sungbeom0324/ETROC_to_FPGA/image/3d_render/ETROC_to_FPGA_Back.png

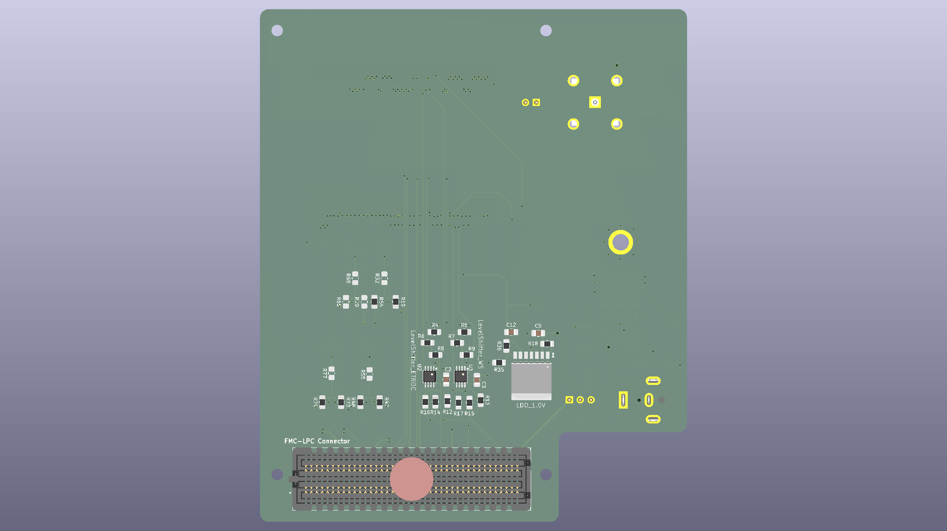
image/3d_render/ETROC_to_FPGA_Back.png
