sungbeom0324/ETROC_to_FPGA/README.md

## ETROC_to_FPGA Board

This board is designed to connect probe card for hybrid (LGAD+ETROC) sensor to FPGA (KC705) board. \
Reversible usage for debugging is also supported, by properly populating components (To be explained).
