sungbeom0324/ETROC_to_FPGA/image/real_picture/Board_Configs_Front.pdf

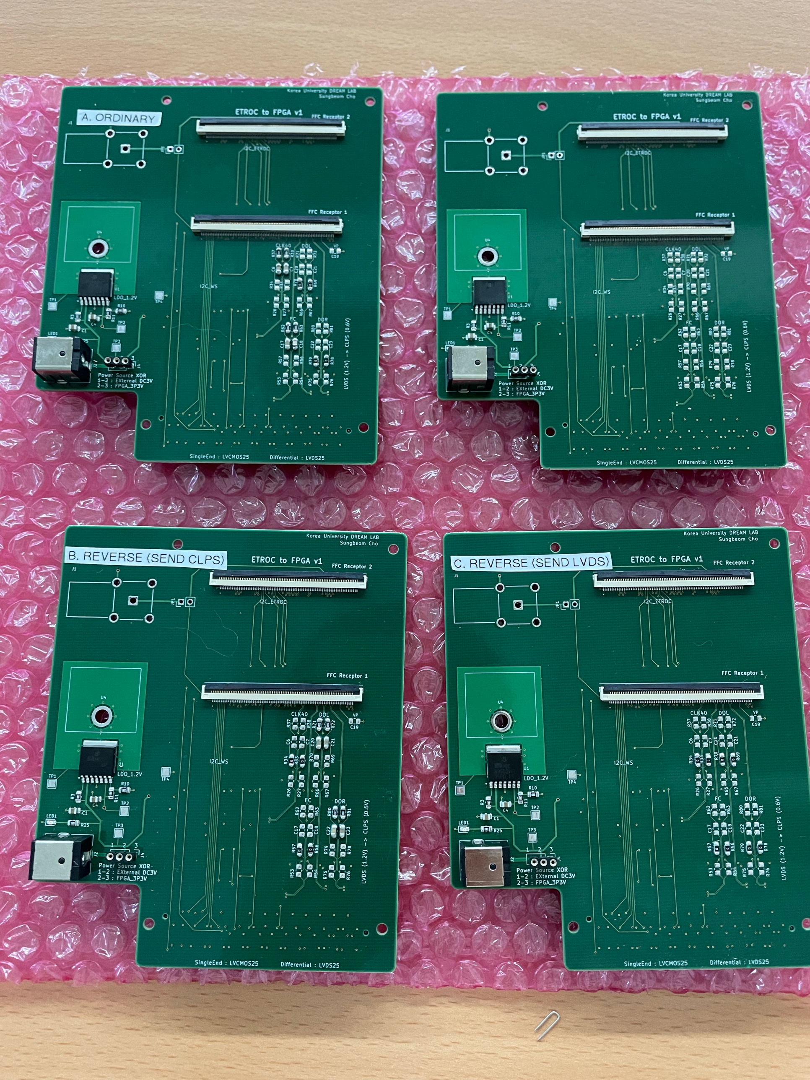
[picture p3: page 1]
