sungbeom0324/ETROC_to_FPGA/image/real_picture/Board_Configs_Rear.pdf

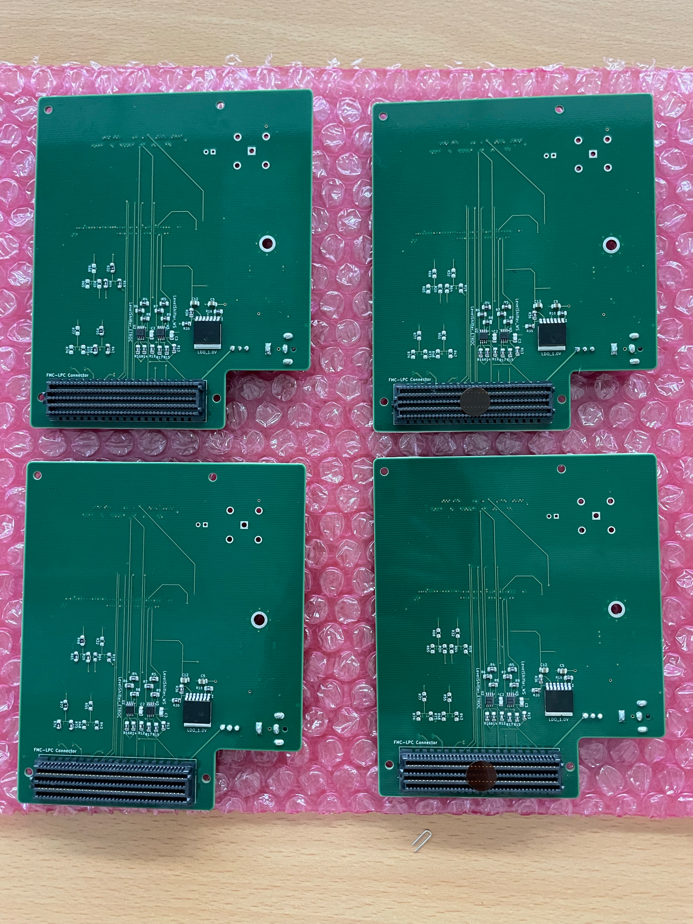
[picture p4: page 1]
