sungbeom0324/ETROC_to_FPGA/image/real_picture/Connect_to_KC705-FMC.pdf

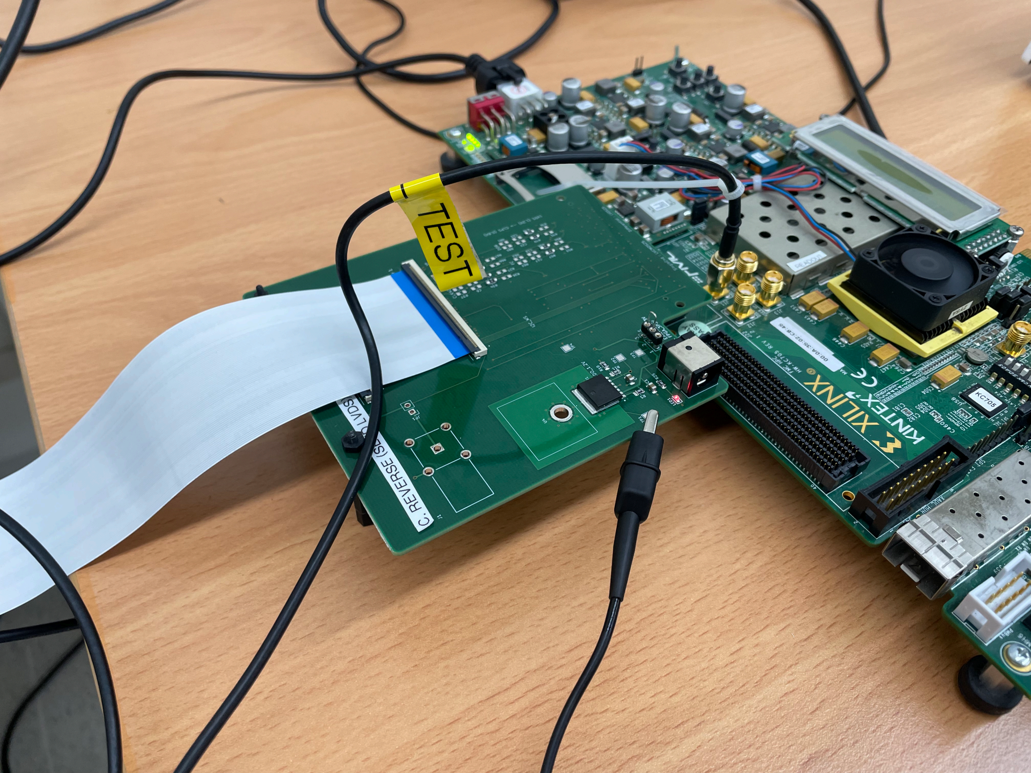
[picture p5: page 1]
