sungbeom0324/ETROC_to_FPGA/image/real_picture/Ordinary_Board_Front.pdf

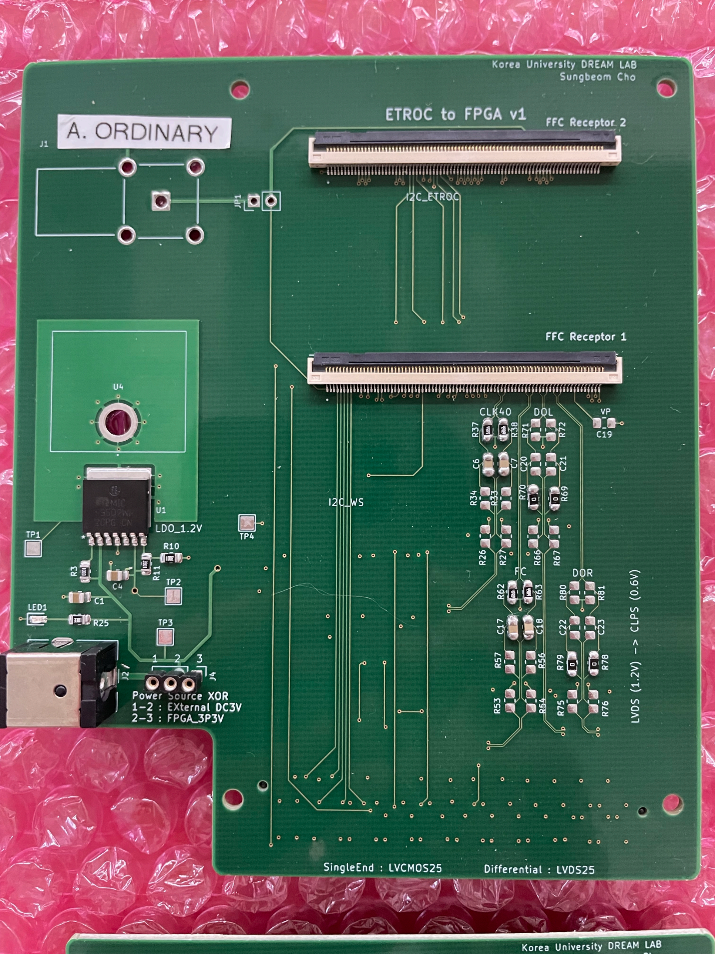
[picture p6: page 1]
