sungbeom0324/ETROC_to_FPGA/image/real_picture/Ordinary_Board_Rear.pdf

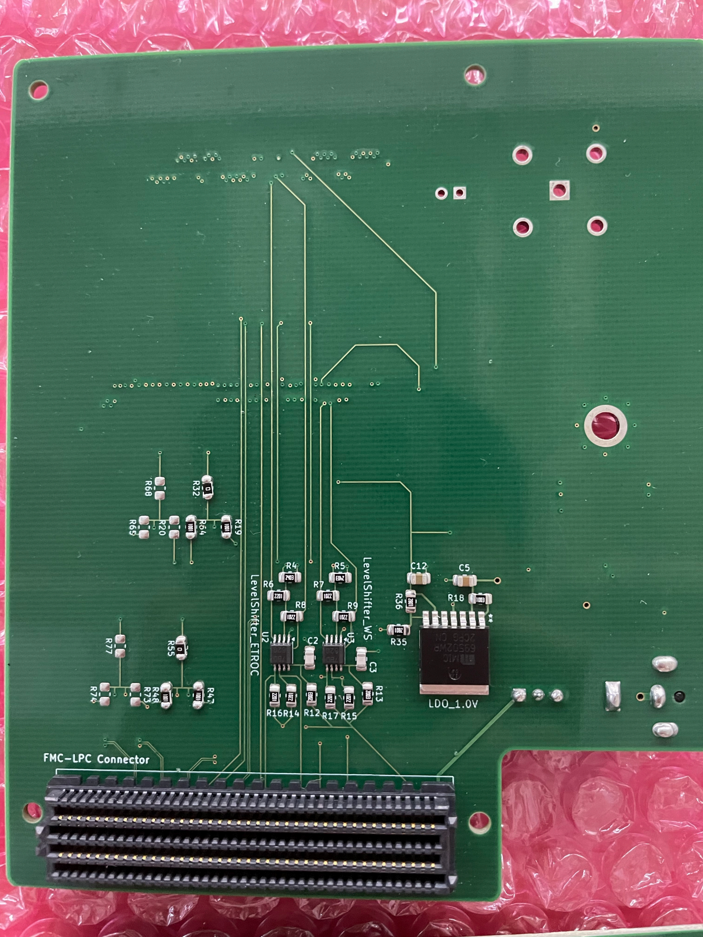
[picture p7: page 1]
