sungbeom0324/ETROC_to_FPGA/Fabrication/BOM/ETROC_to_FPGA_BOM.xlsx

Reference | Qty | Value | DNP | Component | Type | Packed | Footprint | Datasheet | Manufacturer_Part_Number | Mouser Part Number | Description | #
C1,C4,C5,C12 | 4 | 10uF |  | CC0805MKX7R7BB106 | Tape | o | Capacitor_SMD:C_0805_2012Metric_Pad1.18x1.45mm_HandSolder | https://www.mouser.kr/ProductDetail/YAGEO/CC0805MKX7R7BB106?qs=WS5Jv%252B%252Bx1qV0JXGhy8Ef5g%3D%3D |  |  | Unpolarized capacitor | 1
C2,C3 | 2 | 100pF |  | CC0805JRNPO9BN101 | Tape | o | Capacitor_SMD:C_0805_2012Metric_Pad1.18x1.45mm_HandSolder | https://www.mouser.kr/ProductDetail/YAGEO/CC0805JRNPO9BN101?qs=AgBp2OyFlx%252BIBvbseB%252BJ9Q%3D%3D |  |  | Unpolarized capacitor | 2
C6,C7,C17,C18,C20,C21,C22,C23 | 8 | 100n | DNP | CC0805KRX7R9BB104 | Tape |  | Capacitor_SMD:C_0805_2012Metric_Pad1.18x1.45mm_HandSolder | https://www.mouser.kr/ProductDetail/YAGEO/CC0805KRX7R9BB104?qs=vTakOoo5QyLx0lXWgVtRhQ%3D%3D |  |  | Unpolarized capacitor | 3
C19 | 1 | 10n | DNP | N/A | Tape |  | Capacitor_SMD:C_0805_2012Metric_Pad1.18x1.45mm_HandSolder | https://www.mouser.kr/ProductDetail/YAGEO/CC0805MKX7R7BB106?qs=WS5Jv%252B%252Bx1qV0JXGhy8Ef5g%3D%3D |  |  | Unpolarized capacitor | 4
J1 | 1 | Conn_Coaxial | DNP | N/A | N/A |  | ETROC_to_FPGA:BNCLRPC140 |  |  |  | coaxial connector (BNC, SMA, SMB, SMC, Cinch/RCA, LEMO, ...) | 5
J2 | 1 | Barrel_Jack | DNP | PJ-063AH | Bulk | o | Connector_BarrelJack:BarrelJack_CUI_PJ-063AH_Horizontal | https://www.mouser.kr/ProductDetail/Same-Sky/PJ-063AH?qs=WyjlAZoYn51bQfA53nMcVA%3D%3D |  |  | DC Barrel Jack | 6
J3 | 1 | Conn_01x03_Socket | DNP | N/A | N/A |  | Connector:FanPinHeader_1x03_P2.54mm_Vertical |  |  |  | Generic connector, single row, 01x03, script generated | 7
J4 | 1 | Conn_01x03 | DNP | N/A | N/A |  | Connector_PinHeader_2.54mm:PinHeader_1x03_P2.54mm_Vertical |  |  |  | Generic connector, single row, 01x03, script generated (kicad-library-utils/schlib/autogen/connector/) | 8
J5,J6 | 2 | TF06L-80S-0.5SH_800_ |  | TF06L-80S-0.5SH (800) | Tape | o | ETROC_to_FPGA:TF06L80S05SH800 | https://www.mouser.kr/ProductDetail/Hirose-Connector/TF06L-80S-0.5SH800?qs=W0yvOO0ixfGr8OqBVw%252Bw9w%3D%3D | TF06L-80S-0.5SH(800) | 798-TF06L-80S05SH800 | FFC & FPC Connectors | 9
J7 | 1 | ASP-134604-01 |  | ASP-134604-01 | Tape | o | ETROC_to_FPGA:ASP13460401 | https://componentsearchengine.com/Datasheets/2/ASP-134604-01.pdf | ASP-134604-01 | 200-ASP-134604-01 | SAMTEC - ASP-134604-01 - Board-To-Board Connector, Vita 57 XMC, 1.27 mm, 160 Contacts, Header, ASP Series, Surface Mount | 10
JP1 | 1 | Jumper_2_Open | DNP | N/A | N/A |  | Connector_PinHeader_2.54mm:PinHeader_1x02_P2.54mm_Vertical |  |  |  | Jumper, 2-pole, open | 11
LED1 | 1 | LTST-C190KRKT |  | LTST-C190KRKT | Tape | o | LEDC1608X80N | https://componentsearchengine.com/Datasheets/1/LTST-C190KRKT.pdf | LTST-C190KRKT | 859-LTST-C190KRKT | LED,SMD,0603,Red,54mcd,130deg Lite-On LTST-C190KRKT Red LED, 631 nm, 1608 (0603), Rectangle Lens SMD Package | 12
R3,R18 | 2 | 100k |  | RC0805FR-07100KL | Tape | o | Resistor_SMD:R_0805_2012Metric_Pad1.20x1.40mm_HandSolder | https://www.mouser.kr/ProductDetail/YAGEO/RC0805FR-07100KL?qs=8Y8p%252BasKcI7rEWn6FcVdAA%3D%3D |  |  | Resistor | 13
R4,R5 | 2 | 240k |  | RC0805FR-07240KL | Tape | o | Resistor_SMD:R_0805_2012Metric_Pad1.20x1.40mm_HandSolder | https://www.mouser.kr/ProductDetail/YAGEO/RC0805FR-07240KL?qs=fRxXYNj8ftEwbQYL8uxuAg%3D%3D |  |  | Resistor | 14
R6, R7, R8, R9, R14, R15, R16, R17 | 8 | 2.2k |  | RC0805FR-072K2L | Tape | o | Resistor_SMD:R_0805_2012Metric_Pad1.20x1.40mm_HandSolder | https://www.mouser.kr/ProductDetail/YAGEO/RC0805FR-072K2L?qs=CSLd874fYV2eT6iKTza3nw%3D%3D |  |  | Resistor | 15
R26,R27,R53,R54,R66,R67,R75,R76 | 8 | 2.2k | DNP | RC0805FR-072K2L | Tape |  | Resistor_SMD:R_0805_2012Metric_Pad1.20x1.40mm_HandSolder | https://www.mouser.kr/ProductDetail/YAGEO/RC0805FR-072K2L?qs=CSLd874fYV2eT6iKTza3nw%3D%3D |  |  | Resistor | 15
R10 | 1 | 2k |  | RC0805FR-072KL | Tape | o | Resistor_SMD:R_0805_2012Metric_Pad1.20x1.40mm_HandSolder | https://www.mouser.kr/ProductDetail/YAGEO/RC0805FR-072KL?qs=QrWOOBGzeCYk%2Fx0gjMNmqg%3D%3D |  |  | Resistor | 16
R11,R35,R36 | 3 | 2.8k |  | RC0805FR-072K8L | Tape | o | Resistor_SMD:R_0805_2012Metric_Pad1.20x1.40mm_HandSolder | https://www.mouser.kr/ProductDetail/YAGEO/RC0805FR-072K8L?qs=fRxXYNj8ftFpv%2FHTECUVlw%3D%3D |  |  | Resistor | 17
R12,R13 | 2 | 200k |  | RC0805FR-07200KL | Tape | o | Resistor_SMD:R_0805_2012Metric_Pad1.20x1.40mm_HandSolder | https://www.mouser.kr/ProductDetail/YAGEO/RC0805FR-07200KL?qs=8Y8p%252BasKcI4ufYuYh%252BmyZQ%3D%3D |  |  | Resistor | 18
R19,R20,R47,R48,R64,R65,R73,R74 | 8 | 1k | DNP | RC0805FR-071KL | Tape |  | Resistor_SMD:R_0805_2012Metric_Pad1.20x1.40mm_HandSolder | https://www.mouser.kr/ProductDetail/YAGEO/RC0805FR-071KL?qs=1ogmaHw32WJjeGY0DHXakQ%3D%3D |  |  | Resistor | 19
R25 | 1 | 3.3k |  | RC0805FR-073K3L | Tape | o | Resistor_SMD:R_0805_2012Metric_Pad1.20x1.40mm_HandSolder | https://www.mouser.kr/ProductDetail/YAGEO/RC0805FR-073K3L?qs=QrWOOBGzeCZ3pxZtTjPddw%3D%3D |  |  | Resistor | 20
R32,R33,R34,R55,R56,R57,R68,R69,R70,R77,R78,R79 | 12 | 0R | DNP | RC0805JR-070RL | Tape |  | Resistor_SMD:R_0805_2012Metric_Pad1.20x1.40mm_HandSolder | http://industrial.panasonic.com/www-cgi/jvcr13pz.cgi?E+PZ+3+AOA0001+ERJ2GE0R00X+7+WW | ERJ-2GE0R00X | 667-ERJ-2GE0R00X | General Purpose Chip Resistor | 21
R37,R38,R62,R63,R71,R72,R80,R81 | 8 | 50R | DNP | AC0805FR-0749R9L | Tape |  | Resistor_SMD:R_0805_2012Metric_Pad1.20x1.40mm_HandSolder | https://www.mouser.kr/ProductDetail/YAGEO/RC0805FR-0750RL?qs=Jslch3jnSjmZJw3GuNn5kw%3D%3D |  |  | Resistor | 22
U1,U5 | 2 | MIC69502WR |  | MIC69502WR | Tape | o | S-PAK-7_MCH | https://ww1.microchip.com/downloads/aemDocuments/documents/APID/ProductDocuments/DataSheets/MIC69502-5A-Low-VIN-Low-VOUT-%CE%BCCap-LDO-Regulator-DS20006836.pdf |  |  | LDO 3.3 (5)V -> 1.2V, 1.0V | 27
U2,U3 | 2 | PCA9306DCTR |  | PCA9306DCTR | Tape | o | Package_SO:SSOP-8_2.95x2.8mm_P0.65mm | http://www.ti.com/lit/ds/symlink/pca9306.pdf |  |  | Dual bidirectional I2C Bus and SMBus voltage level translator | 28
U4 | 1 | 504102B00000G | DNP | 504102B00000G | Bulk | o | 504102B00000G | https://www.mouser.kr/ProductDetail/Aavid/504102B00000G?qs=MJut%252BdqOEgj5oeHehsjqHA%3D%3D | 504102B00000G | 532-504102B00 | Heatsink, TO-220, 15.6C/W, 19.8 x 17.8 x 21.6mm, Through Hole | 29
