sungbeom0324/ETROC_to_FPGA/3D/LTST-C190KRKT.stp

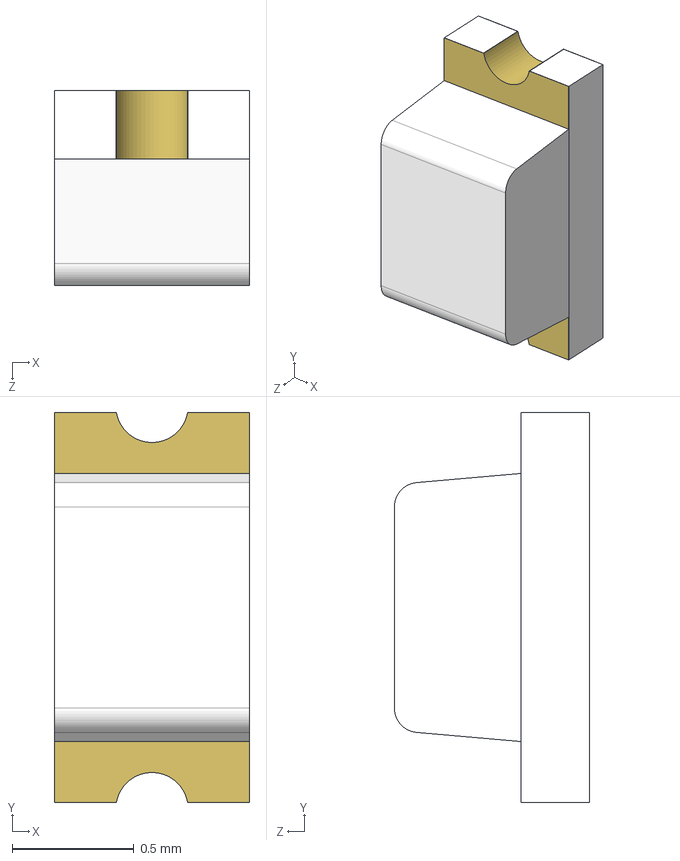
[picture p8: CAD file, 2026-05-17]
3D/LTST-C190KRKT.stp
0.8 x 1.60 x 0.801 mm
