sungbeom0324/ETROC_to_FPGA/3D/S-PAK-7_MCH.step

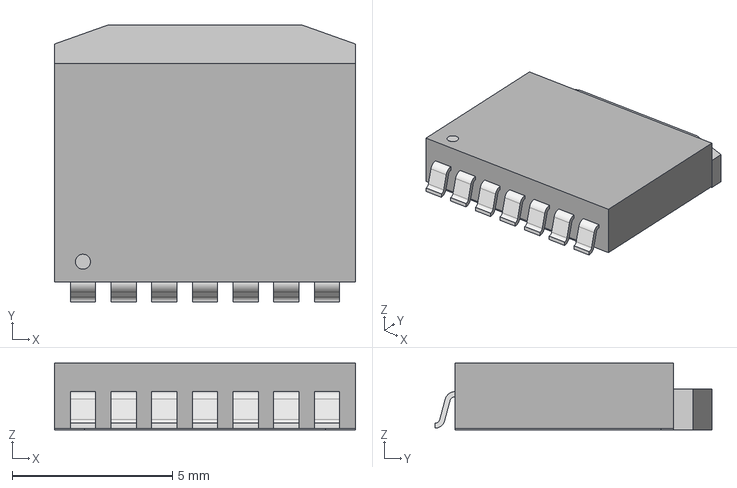
[picture p9: CAD file, 2026-05-17]
3D/S-PAK-7_MCH.step
9.40 x 8.66 x 2.09 mm
