sungbeom0324/ETROC_to_FPGA/3D/TF06L-80S-0.5SH_800_.stp

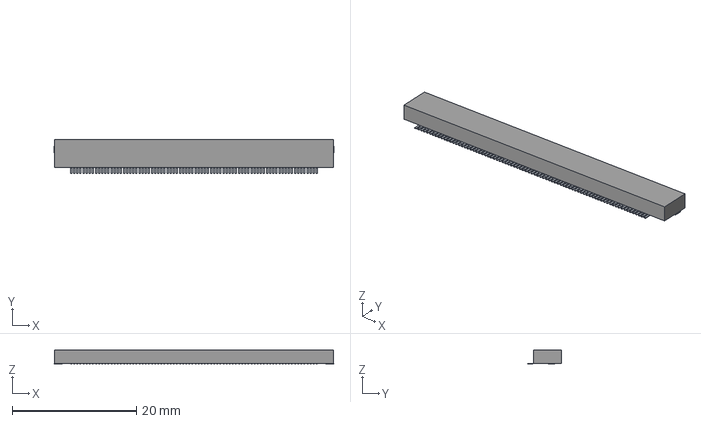
[picture p10: CAD file, 2026-05-17]
3D/TF06L-80S-0.5SH_800_.stp
45.0 x 5.42 x 2.30 mm
Pins
