sungbeom0324/ETROC_to_FPGA/3D/ERJ-2GE0R00X.stp

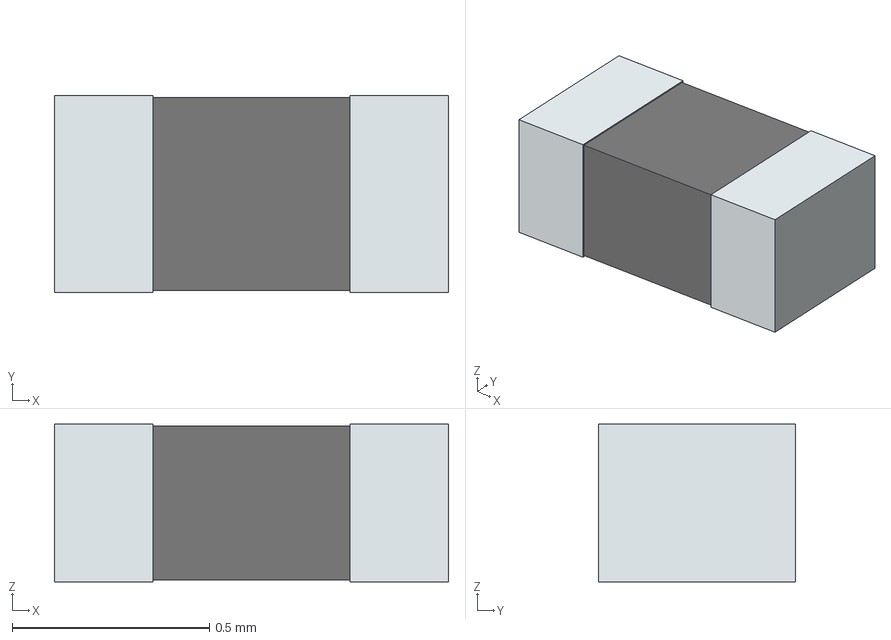
[picture p11: CAD file, 2026-05-17]
3D/ERJ-2GE0R00X.stp
1.00 x 0.5 x 0.4 mm
term1
term2
