sungbeom0324/ETROC_to_FPGA/3D/ASP-134488-01.stp

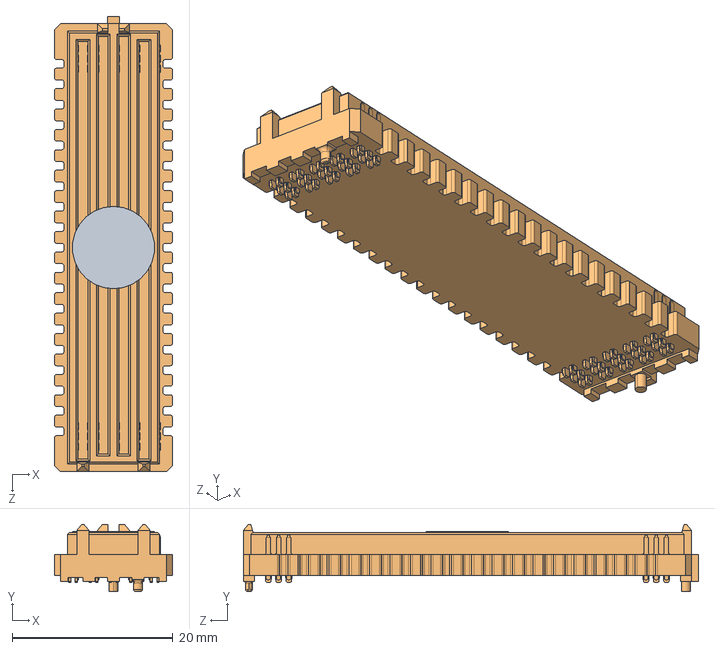
[picture p12: CAD file, 2026-05-17]
3D/ASP-134488-01.stp
14.7 x 8.38 x 56.7 mm
