sungbeom0324/ETROC_to_FPGA/3D/BNC-LR-PC-1_40_.stp

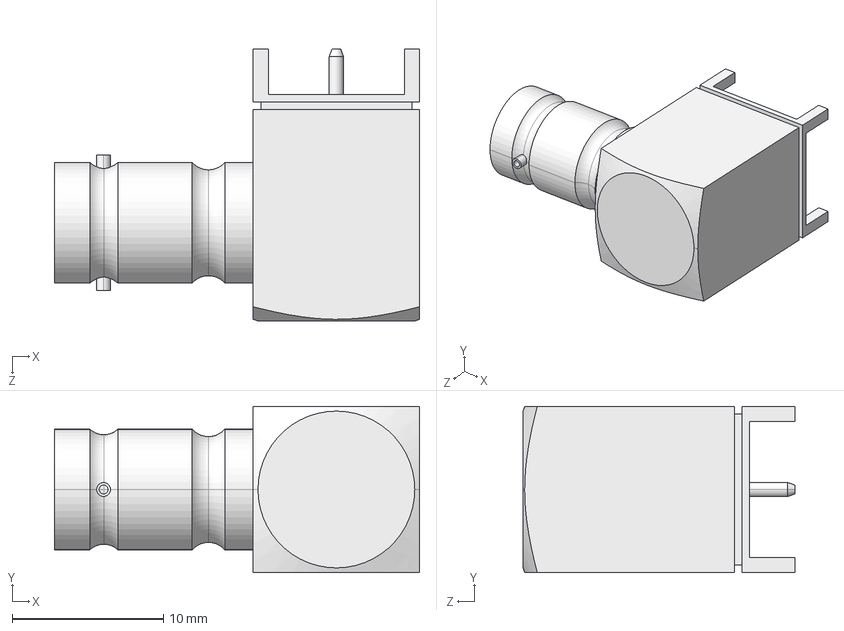
[picture p13: CAD file, 2026-05-17]
3D/BNC-LR-PC-1_40_.stp
24.1 x 11.0 x 18.0 mm
