sungbeom0324/ETROC_to_FPGA/3D/ASP-134486-01.stp

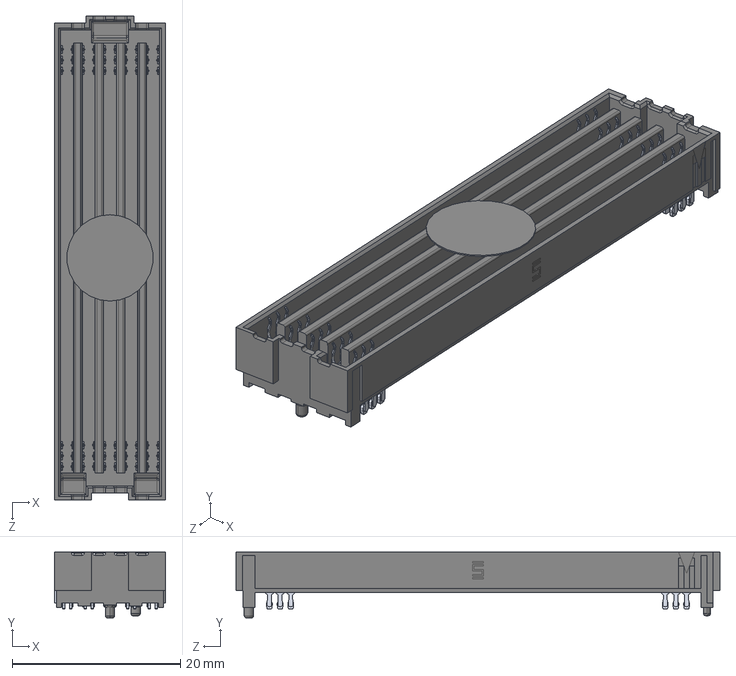
[picture p14: CAD file, 2026-05-17]
3D/ASP-134486-01.stp
13.2 x 7.82 x 57.5 mm
