sungbeom0324/ETROC_to_FPGA/3D/HSE19-361616P.stp

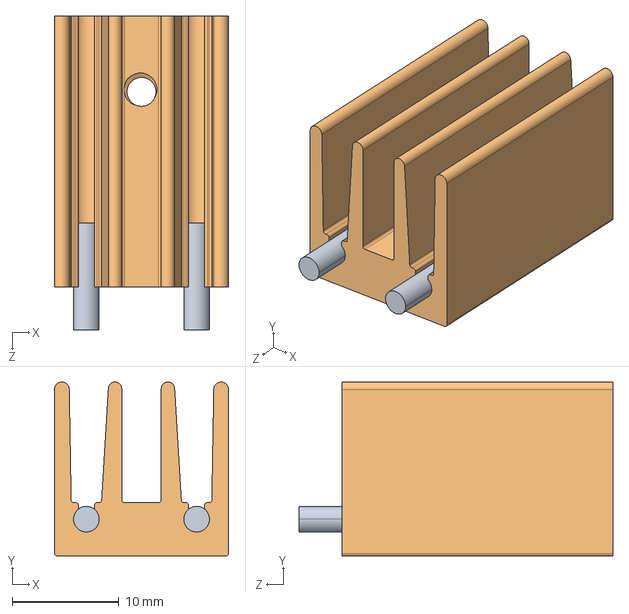
[picture p15: CAD file, 2026-05-17]
3D/HSE19-361616P.stp
16.3 x 16.3 x 29.4 mm
