sungbeom0324/ETROC_to_FPGA/3D/504102B00000G.stp

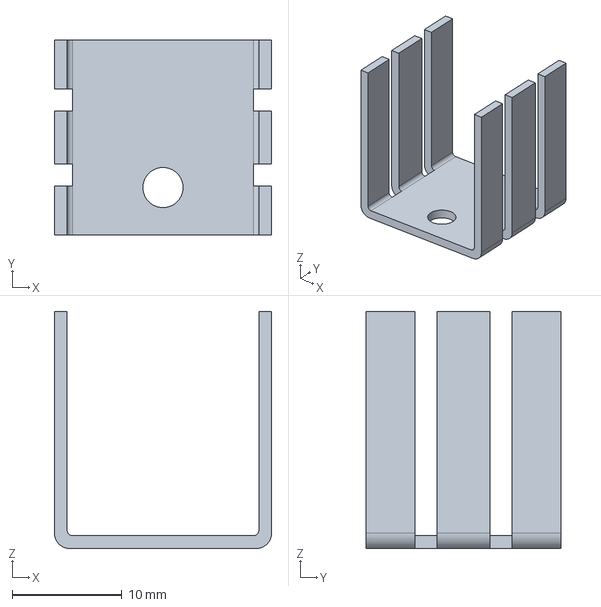
[picture p16: CAD file, 2026-05-17]
3D/504102B00000G.stp
19.8 x 17.8 x 21.6 mm
