sungbeom0324/ETROC_to_FPGA/3D/694106301002.stp

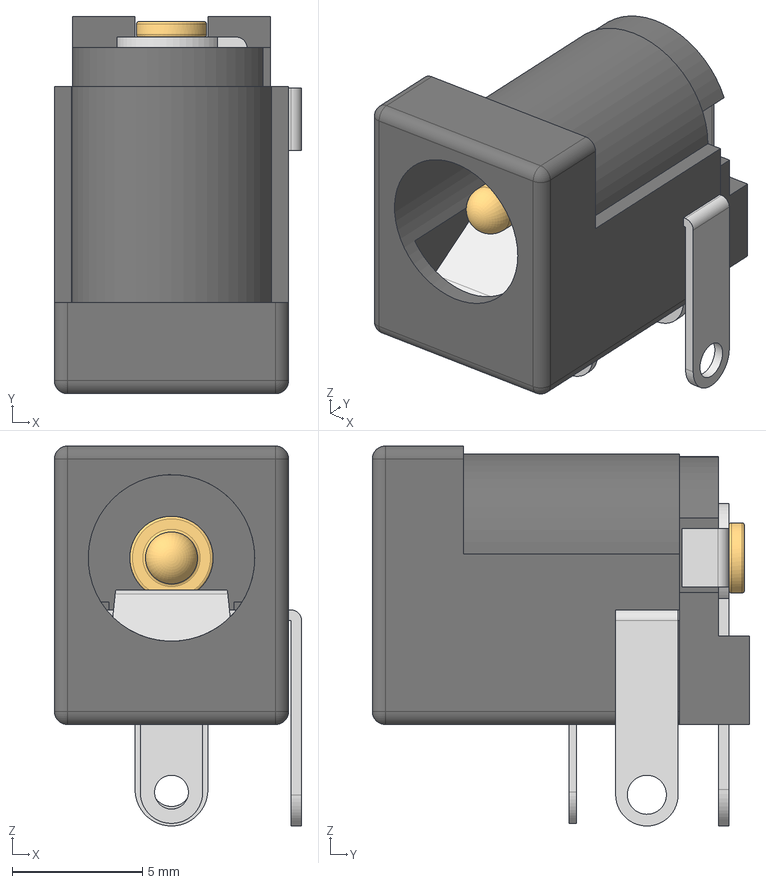
[picture p17: CAD file, 2026-05-17]
3D/694106301002.stp
9.50 x 14.5 x 14.6 mm
6941xx301002
694106301002_PinContact
6941xx301002_Back
6941xx301002_PinContact2
6941xx301002_PinLame
6941xx301002_PinBis
