sungbeom0324/ETROC_to_FPGA/3D/5226993-3.stp

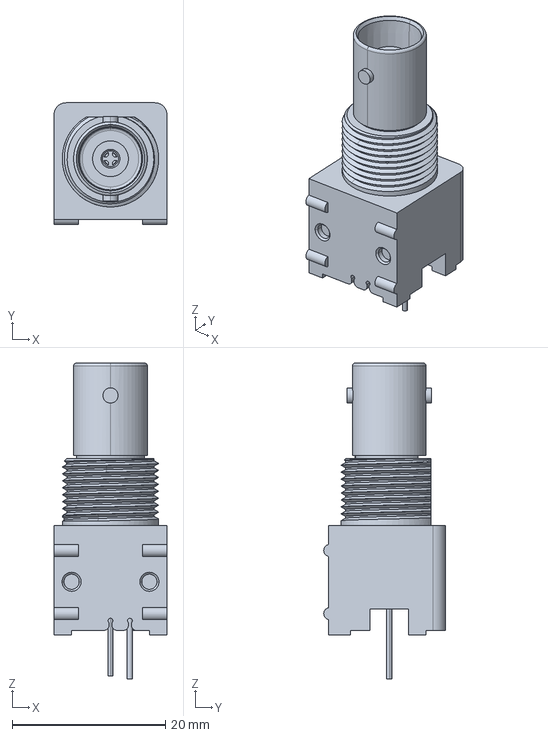
[picture p18: CAD file, 2026-05-17]
3D/5226993-3.stp
14.8 x 15.9 x 41.3 mm
