sungbeom0324/ETROC_to_FPGA/image/real_picture/Reverse_Board_Test_Setup.pdf

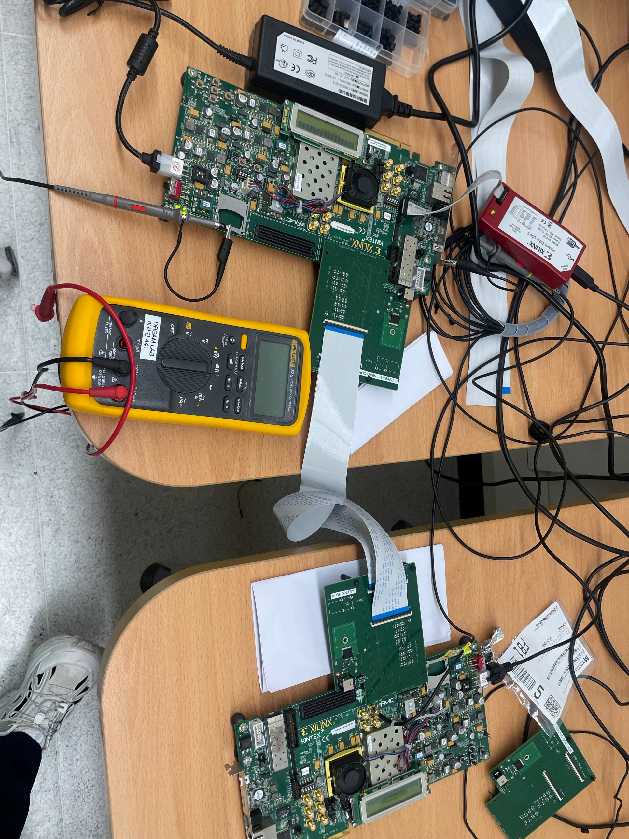
[picture p19: page 1]
