sungbeom0324/ETROC_to_FPGA/image/schematic/ETROC_to_FPGA_schematic.pdf

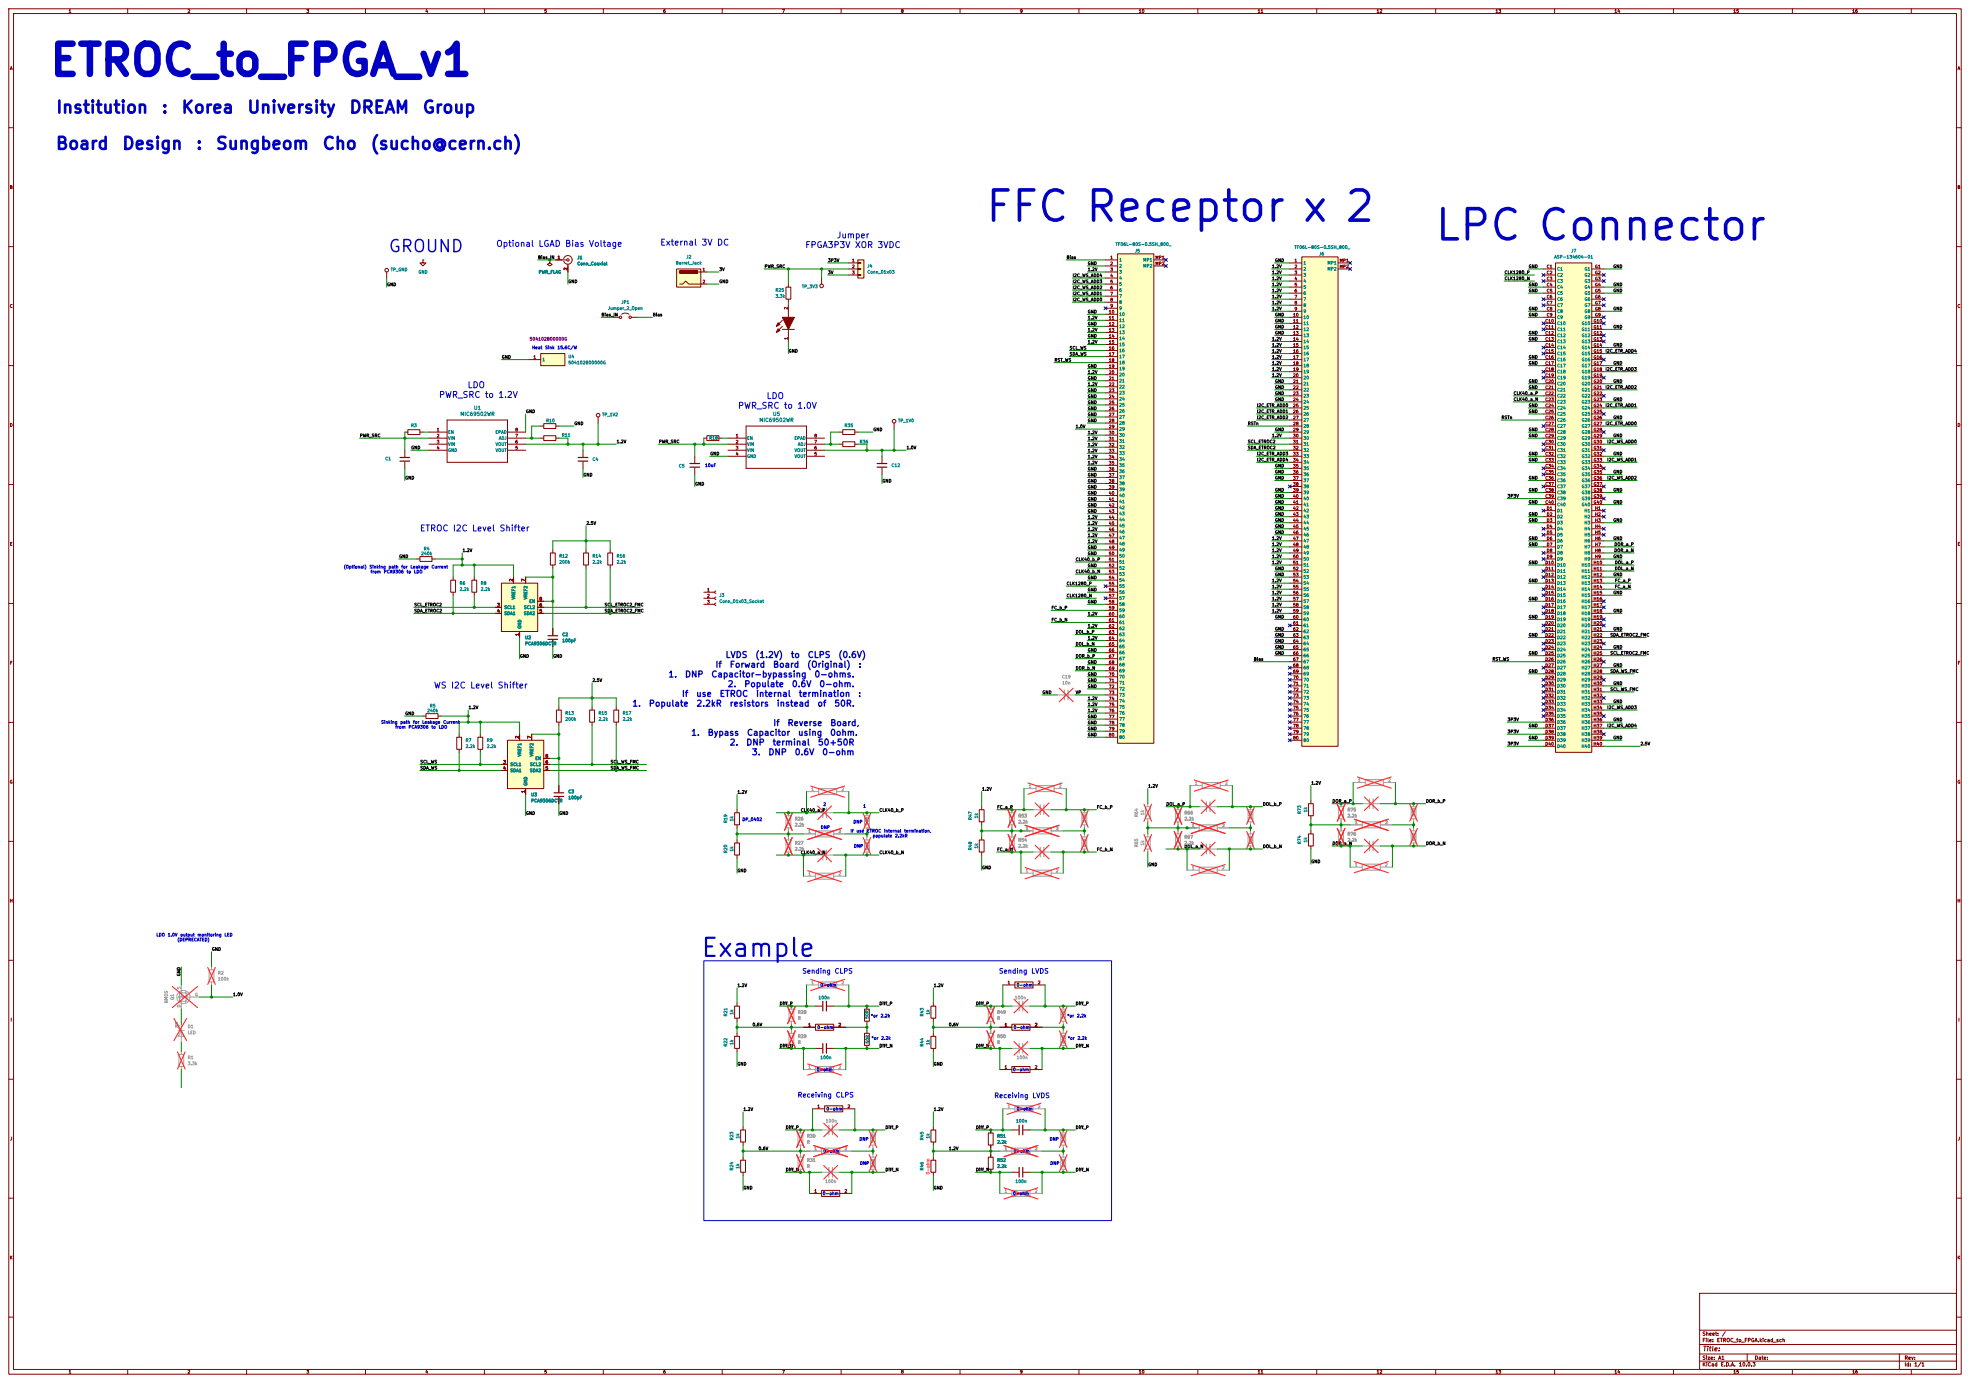
[picture p20: page 1]

Institution : Korea University DREAM Group
Board Design : Sungbeom Cho (sucho@cern.ch)

Optional LGAD Bias Voltage

(Optional) Sinking path for Leakage Current

2 LVDS (1.2V) to CLPS (0.6V)
If Forward Board (Original) :
2. Populate 0.6V 0-ohm.

1. DNP Capacitor-bypassing 0-ohms.
If use ETROC internal termination :

0-ohm WS I2C Level Shifter

1. Populate 2.2kR resistors instead of 50R.

Sinking path for Leakage Current

If use ETROC internal termination,

LDO 1.0V output monitoring LED

Size: A1 | Rev:
KiCad E.D.A. 10.0.3 | Id: 1/1
