sungbeom0324/ETROC_to_FPGA/ETROC_to_FPGA.kicad_pcb

## KiCad design ETROC_to_FPGA.kicad_pcb (2026-08-05)

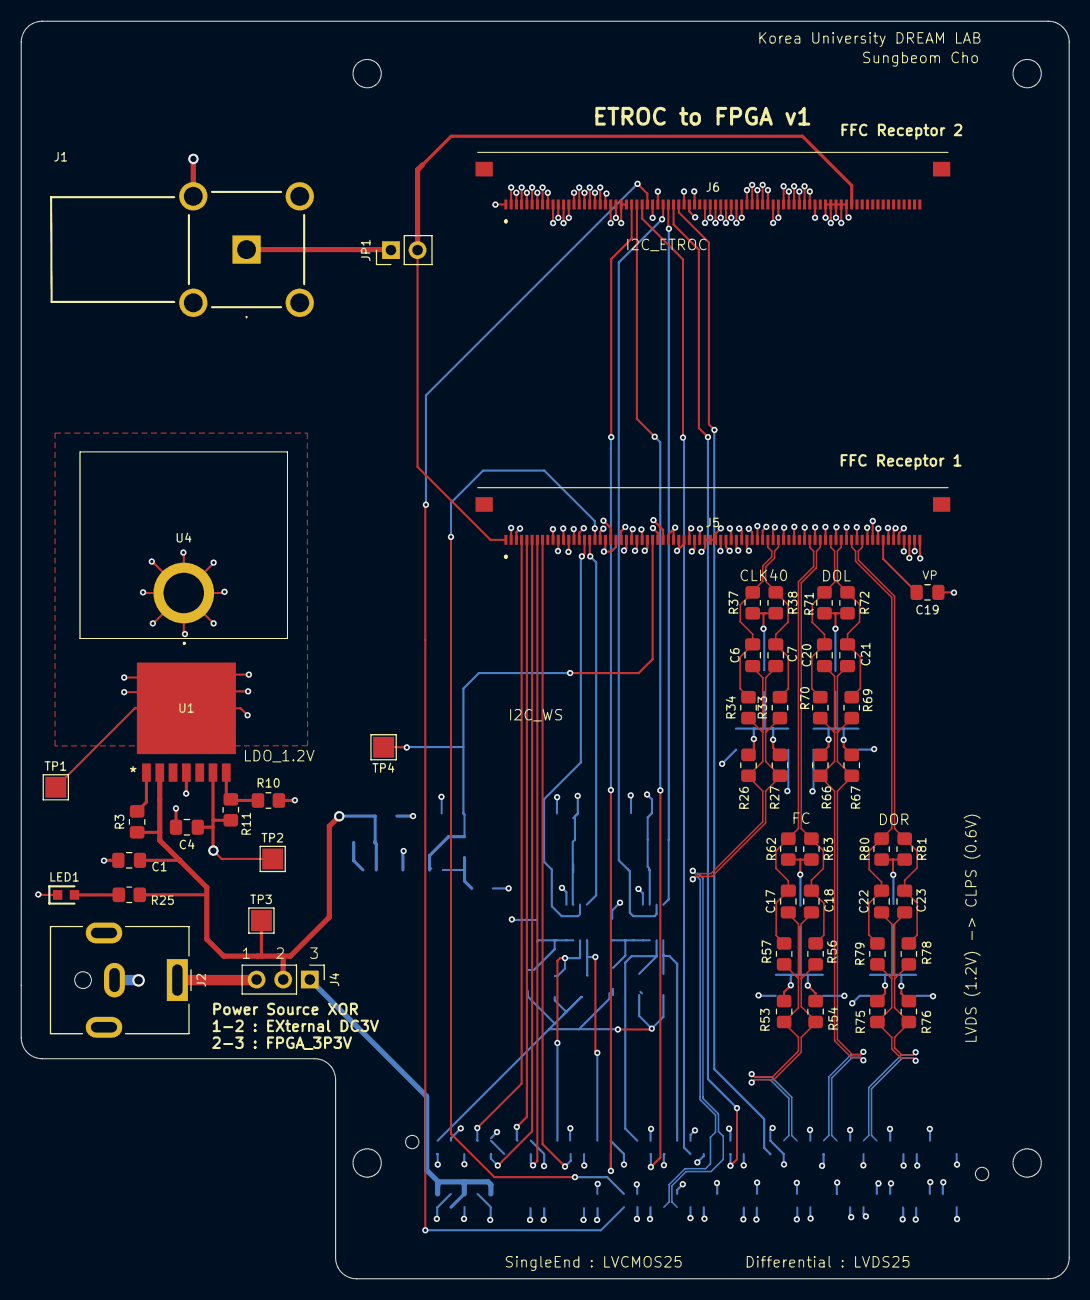
[picture p21: board ETROC_to_FPGA.kicad_pcb from above]

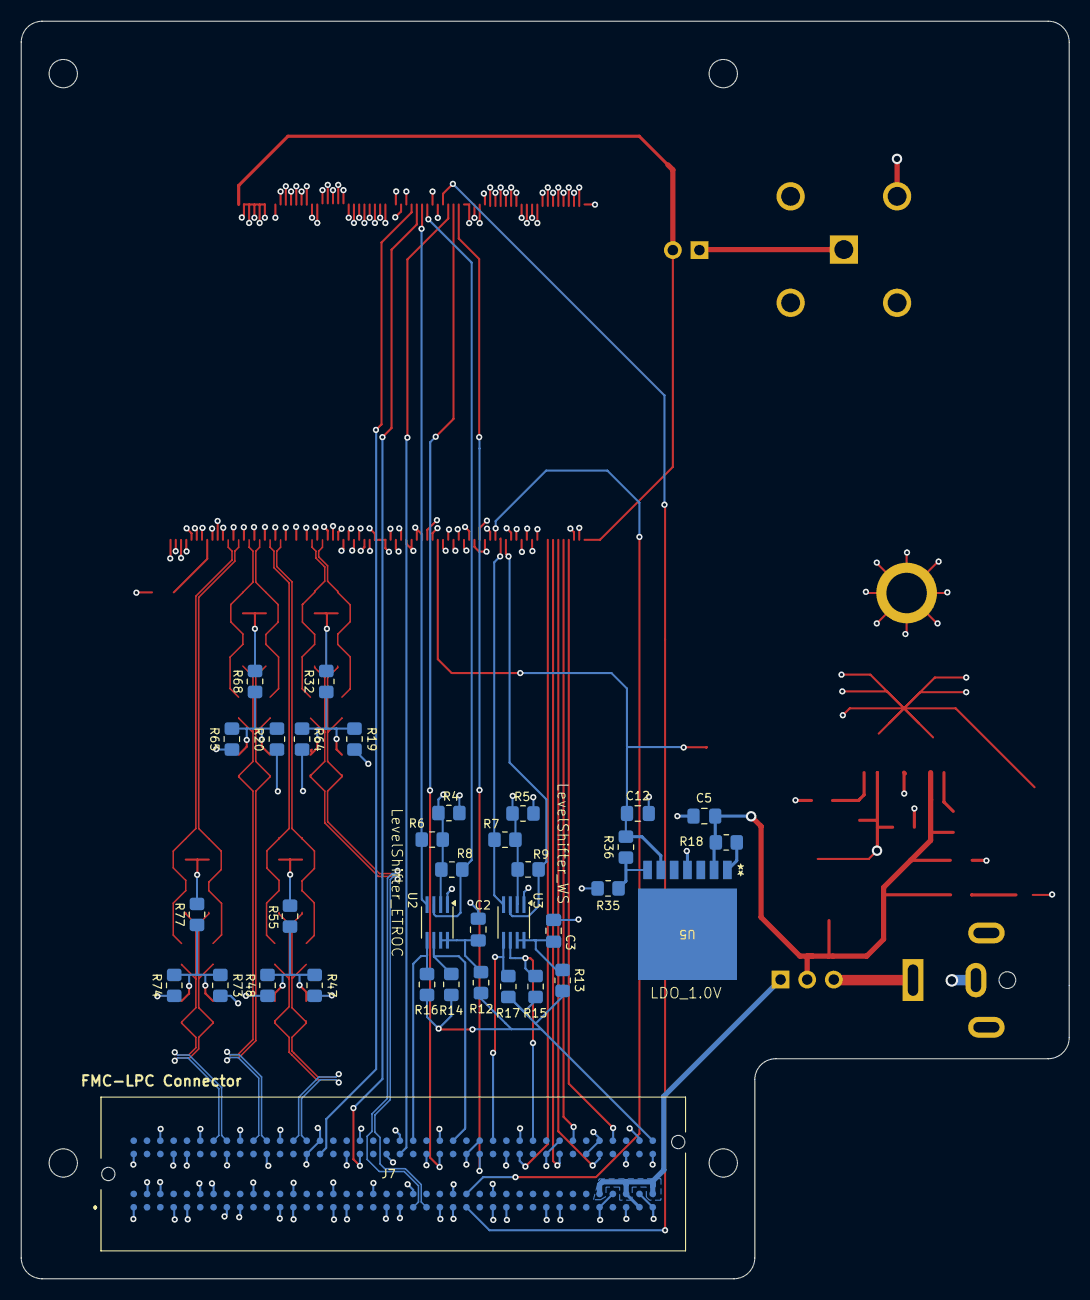
[picture p22: board ETROC_to_FPGA.kicad_pcb from below]

Board: 4 copper layers, 100.0 x 120.0 mm, 91 parts (35 on the bottom side), 61 nets.

Parts:
C1, C4, C5, C12: 10uF; C_0805_2012Metric_Pad1.18x1.45mm_HandSolder
C2, C3: 100pF; C_0805_2012Metric_Pad1.18x1.45mm_HandSolder
C6, C7, C17, C18, C20, C21, C22, C23: 100n; C_0805_2012Metric_Pad1.18x1.45mm_HandSolder
C19: 10n; C_0805_2012Metric_Pad1.18x1.45mm_HandSolder
Hole1, Hole2: MountingHole_2.7mm_M2.5
J1: Conn_Coaxial; BNCLRPC140
J2: Barrel_Jack; BarrelJack_CUI_PJ-063AH_Horizontal
J4: Conn_01x03; PinHeader_1x03_P2.54mm_Vertical
J5, J6: TF06L-80S-0.5SH_800_; TF06L80S05SH800
J7: ASP-134604-01; ASP13460401
JP1: Jumper_2_Open; PinHeader_1x02_P2.54mm_Vertical
LED1: LTST-C190KRKT; LEDC1608X80N
R3, R18: 100k; R_0805_2012Metric_Pad1.20x1.40mm_HandSolder
R4, R5: 240k; R_0805_2012Metric_Pad1.20x1.40mm_HandSolder
R6, R7, R8, R9, R14, R15, R16, R17, R26, R27, R53, R54, R66, R67, R75, R76: 2.2k; R_0805_2012Metric_Pad1.20x1.40mm_HandSolder
R10: 2k; R_0805_2012Metric_Pad1.20x1.40mm_HandSolder
R11, R35, R36: 2.8k; R_0805_2012Metric_Pad1.20x1.40mm_HandSolder
R12, R13: 200k; R_0805_2012Metric_Pad1.20x1.40mm_HandSolder
R19, R20, R47, R48, R64, R65, R73, R74: 1k; R_0805_2012Metric_Pad1.20x1.40mm_HandSolder
R25: 3.3k; R_0805_2012Metric_Pad1.20x1.40mm_HandSolder
R32, R33, R34, R55, R56, R57, R68, R69, R70, R77, R78, R79: 0; R_0805_2012Metric_Pad1.20x1.40mm_HandSolder
R37, R38, R62, R63, R71, R72, R80, R81: 50R; R_0805_2012Metric_Pad1.20x1.40mm_HandSolder
Spacer: MountingHole_2.7mm_M2.5
Spacer#2: MountingHole_2.7mm_M2.5
TP1: TP_GND; TestPoint_Pad_2.0x2.0mm
TP2: TP_1V2; TestPoint_Pad_2.0x2.0mm
TP3: TP_3V3; TestPoint_Pad_2.0x2.0mm
TP4: TP_1V0; TestPoint_Pad_2.0x2.0mm
U1, U5: MIC69502WR; S-PAK-7_MCH
U2, U3: PCA9306DCTR; SSOP-8_2.95x2.8mm_P0.65mm
U4: 504102B00000G

Connections:
/1.0V: C12.1, J5.29, R36.2, TP4.1 (1_1), U5.6 (VOUT)
/1.2V: C4.1, J5.3, J5.11, J5.13, J5.15, J5.20, J5.22, J5.30, J5.31, J5.32, J5.33, J5.34, J5.35, J5.44, J5.45, J5.46, J5.47, J5.48, J5.60, J5.62, J5.64, J5.74, J5.75, J5.76, J6.2, J6.3, J6.4, J6.5, J6.6, J6.7, J6.8, J6.9, J6.14, J6.15, J6.16, J6.17, J6.18, J6.19, J6.20, J6.30, J6.47, J6.48, J6.49, J6.50, J6.51, J6.54, J6.55, J6.56, J6.57, J6.58, J6.59, R4.2, R5.2, R6.1, R7.1, R8.1, R9.1, R11.2, R19.2, R47.2, R64.2, R73.2, TP2.1 (1_1), U1.6 (VOUT), U2.2 (VREF1), U3.2 (VREF1)
/2.5V: J7.H40, R12.1, R13.1, R14.1, R15.1, R16.1, R17.1
/3P3V: J4.1, J7.C39, J7.D36, J7.D38, J7.D40
/3V: J2.1, J4.3
/Bias: J5.1, J6.67, JP1.2 (B)
/Bias_IN: J1.1 (In), JP1.1 (A)
/CLK40_a_N: C7.1, J7.C23, R27.1, R33.1
/CLK40_a_P: C6.1, J7.C22, R26.1, R34.1
/CLK40_b_N: C7.2, J5.53, R33.2, R38.1
/CLK40_b_P: C6.2, J5.51, R34.2, R37.1
/DOL_a_N: C21.1, J7.H11, R67.1, R69.1
/DOL_a_P: C20.1, J7.H10, R66.1, R70.1
/DOL_b_N: C21.2, J5.65, R69.2, R72.1
/DOL_b_P: C20.2, J5.63, R70.2, R71.1
/DOR_a_N: C23.1, J7.H8, R76.1, R78.1
/DOR_a_P: C22.1, J7.H7, R75.1, R79.1
/DOR_b_N: C23.2, J5.69, R78.2, R81.1
/DOR_b_P: C22.2, J5.67, R79.2, R80.1
/FC_a_N: C18.1, J7.H14, R54.1, R56.1
/FC_a_P: C17.1, J7.H13, R53.1, R57.1
/FC_b_N: C18.2, J5.61, R56.2, R63.1
/FC_b_P: C17.2, J5.59, R57.2, R62.1
/I2C_ETR_ADD0: J6.25, J7.G27
/I2C_ETR_ADD1: J6.26, J7.G24
/I2C_ETR_ADD2: J6.27, J7.G21
/I2C_ETR_ADD3: J6.33, J7.G18
/I2C_ETR_ADD4: J6.34, J7.G15
/I2C_WS_ADD0: J5.8, J7.G30
/I2C_WS_ADD1: J5.7, J7.G33
/I2C_WS_ADD2: J5.6, J7.G36
/I2C_WS_ADD3: J5.5, J7.H34
/I2C_WS_ADD4: J5.4, J7.H37
/PWR_SRC: C1.1, C5.1, J4.2, R3.1, R18.1, R25.1, TP3.1 (1_1), U1.2 (VIN), U5.2 (VIN)
/RST_WS: J5.18, J7.D26
/RSTn: J6.28, J7.C26
/SCL_ETROC2: J6.31, R8.2, U2.3 (SCL1)
/SCL_ETROC2_FMC: J7.H25, R14.2, U2.6 (SCL2)
/SCL_WS: J5.16, R9.2, U3.3 (SCL1)
/SCL_WS_FMC: J7.H31, R15.2, U3.6 (SCL2)
/SDA_ETROC2: J6.32, R6.2, U2.4 (SDA1)
/SDA_ETROC2_FMC: J7.H22, R16.2, U2.5 (SDA2)
/SDA_WS: J5.17, R7.2, U3.4 (SDA1)
/SDA_WS_FMC: J7.H28, R17.2, U3.5 (SDA2)
/VP: C19.2, J5.73
GND: C1.2, C2.2, C3.2, C4.2, C5.2, C12.2, C19.1, J1.2 (Ext), J2.2, J5.2, J5.10, J5.12, J5.14, J5.19, J5.21, J5.23, J5.24, J5.25, J5.26, J5.27, J5.28, J5.36, J5.37, J5.38, J5.39, J5.40, J5.41, J5.42, J5.43, J5.49, J5.50, J5.52, J5.54, J5.56, J5.58, J5.66, J5.68, J5.70, J5.71, J5.72, J5.77, J5.78, J5.79, J5.80, J6.1, J6.10, J6.11, J6.12, J6.13, J6.21, J6.22, J6.23, J6.24, J6.29, J6.35, J6.36, J6.37, J6.39, J6.40, J6.41, J6.42, J6.43, J6.44, J6.45, J6.46, J6.52, J6.53, J6.60, J6.62, J6.63, J6.64, J6.65, J6.66, J7.C1, J7.C4, J7.C5, J7.C8, J7.C9, J7.C12, J7.C13, J7.C16, J7.C17, J7.C20, J7.C21, J7.C24, J7.C25, J7.C28, J7.C29, J7.C32, J7.C33, J7.C36, J7.C38, J7.C40, J7.D2, J7.D3, J7.D6, J7.D7, J7.D10, J7.D13, J7.D16, J7.D19, J7.D22, J7.D25, J7.D28, J7.D37, J7.D39, J7.G1, J7.G4, J7.G5, J7.G8, J7.G11, J7.G14, J7.G17, J7.G20, J7.G23, J7.G26, J7.G29, J7.G32, J7.G35, J7.G38, J7.G40, J7.H3, J7.H6, J7.H9, J7.H12, J7.H15, J7.H18, J7.H21, J7.H24, J7.H27, J7.H30, J7.H33, J7.H36, J7.H39, LED1.1 (K), R4.1, R5.1, R10.2, R20.1, R35.2, R48.1, R65.1, R74.1, TP1.1 (1_1), U1.4 (GND), U1.8 (EPAD), U2.1 (GND), U3.1 (GND), U4.1 (1_1), U5.4 (GND)
unnamed: LED1.2 (A), R25.2
unnamed: R19.1, R20.2, R26.2, R27.2, R32.1
unnamed: R32.2, R37.2, R38.2
unnamed: R47.1, R48.2, R53.2, R54.2, R55.1
unnamed: R55.2, R62.2, R63.2
unnamed: R64.1, R65.2, R66.2, R67.2, R68.1
unnamed: R68.2, R71.2, R72.2
unnamed: R73.1, R74.2, R75.2, R76.2, R77.1
unnamed: R77.2, R80.2, R81.2
unnamed: R10.1, R11.1, U1.7 (ADJ)
unnamed: R3.2, U1.1 (EN)
unnamed: C2.1, R12.2, U2.7 (VREF2), U2.8 (EN)
unnamed: C3.1, R13.2, U3.7 (VREF2), U3.8 (EN)
unnamed: R35.1, R36.1, U5.7 (ADJ)
unnamed: R18.2, U5.1 (EN)
