sungbeom0324/ETROC_to_FPGA/(commit log)

2026-05-18 include images
    [ETROC_to_FPGA.kicad_pcb, ETROC_to_FPGA.kicad_sch]
2026-08-05 Fabricated ETROC_to_FPGA_v1
    [ETROC_to_FPGA-B_Cu.gbr, ETROC_to_FPGA-B_Mask.gbr, ETROC_to_FPGA-B_Paste.gbr, ETROC_to_FPGA-B_Silkscreen.gbr, ETROC_to_FPGA-Edge_Cuts.gbr, ETROC_to_FPGA-F_Cu.gbr, ETROC_to_FPGA-F_Mask.gbr, ETROC_to_FPGA-F_Paste.gbr]
